Shipwrecked-Alchemists/m20/m20kicad.kicad_pcb

## KiCad design sensorOne/hardware/sensorOnePcb/sensorOnePcb.kicad_pcb

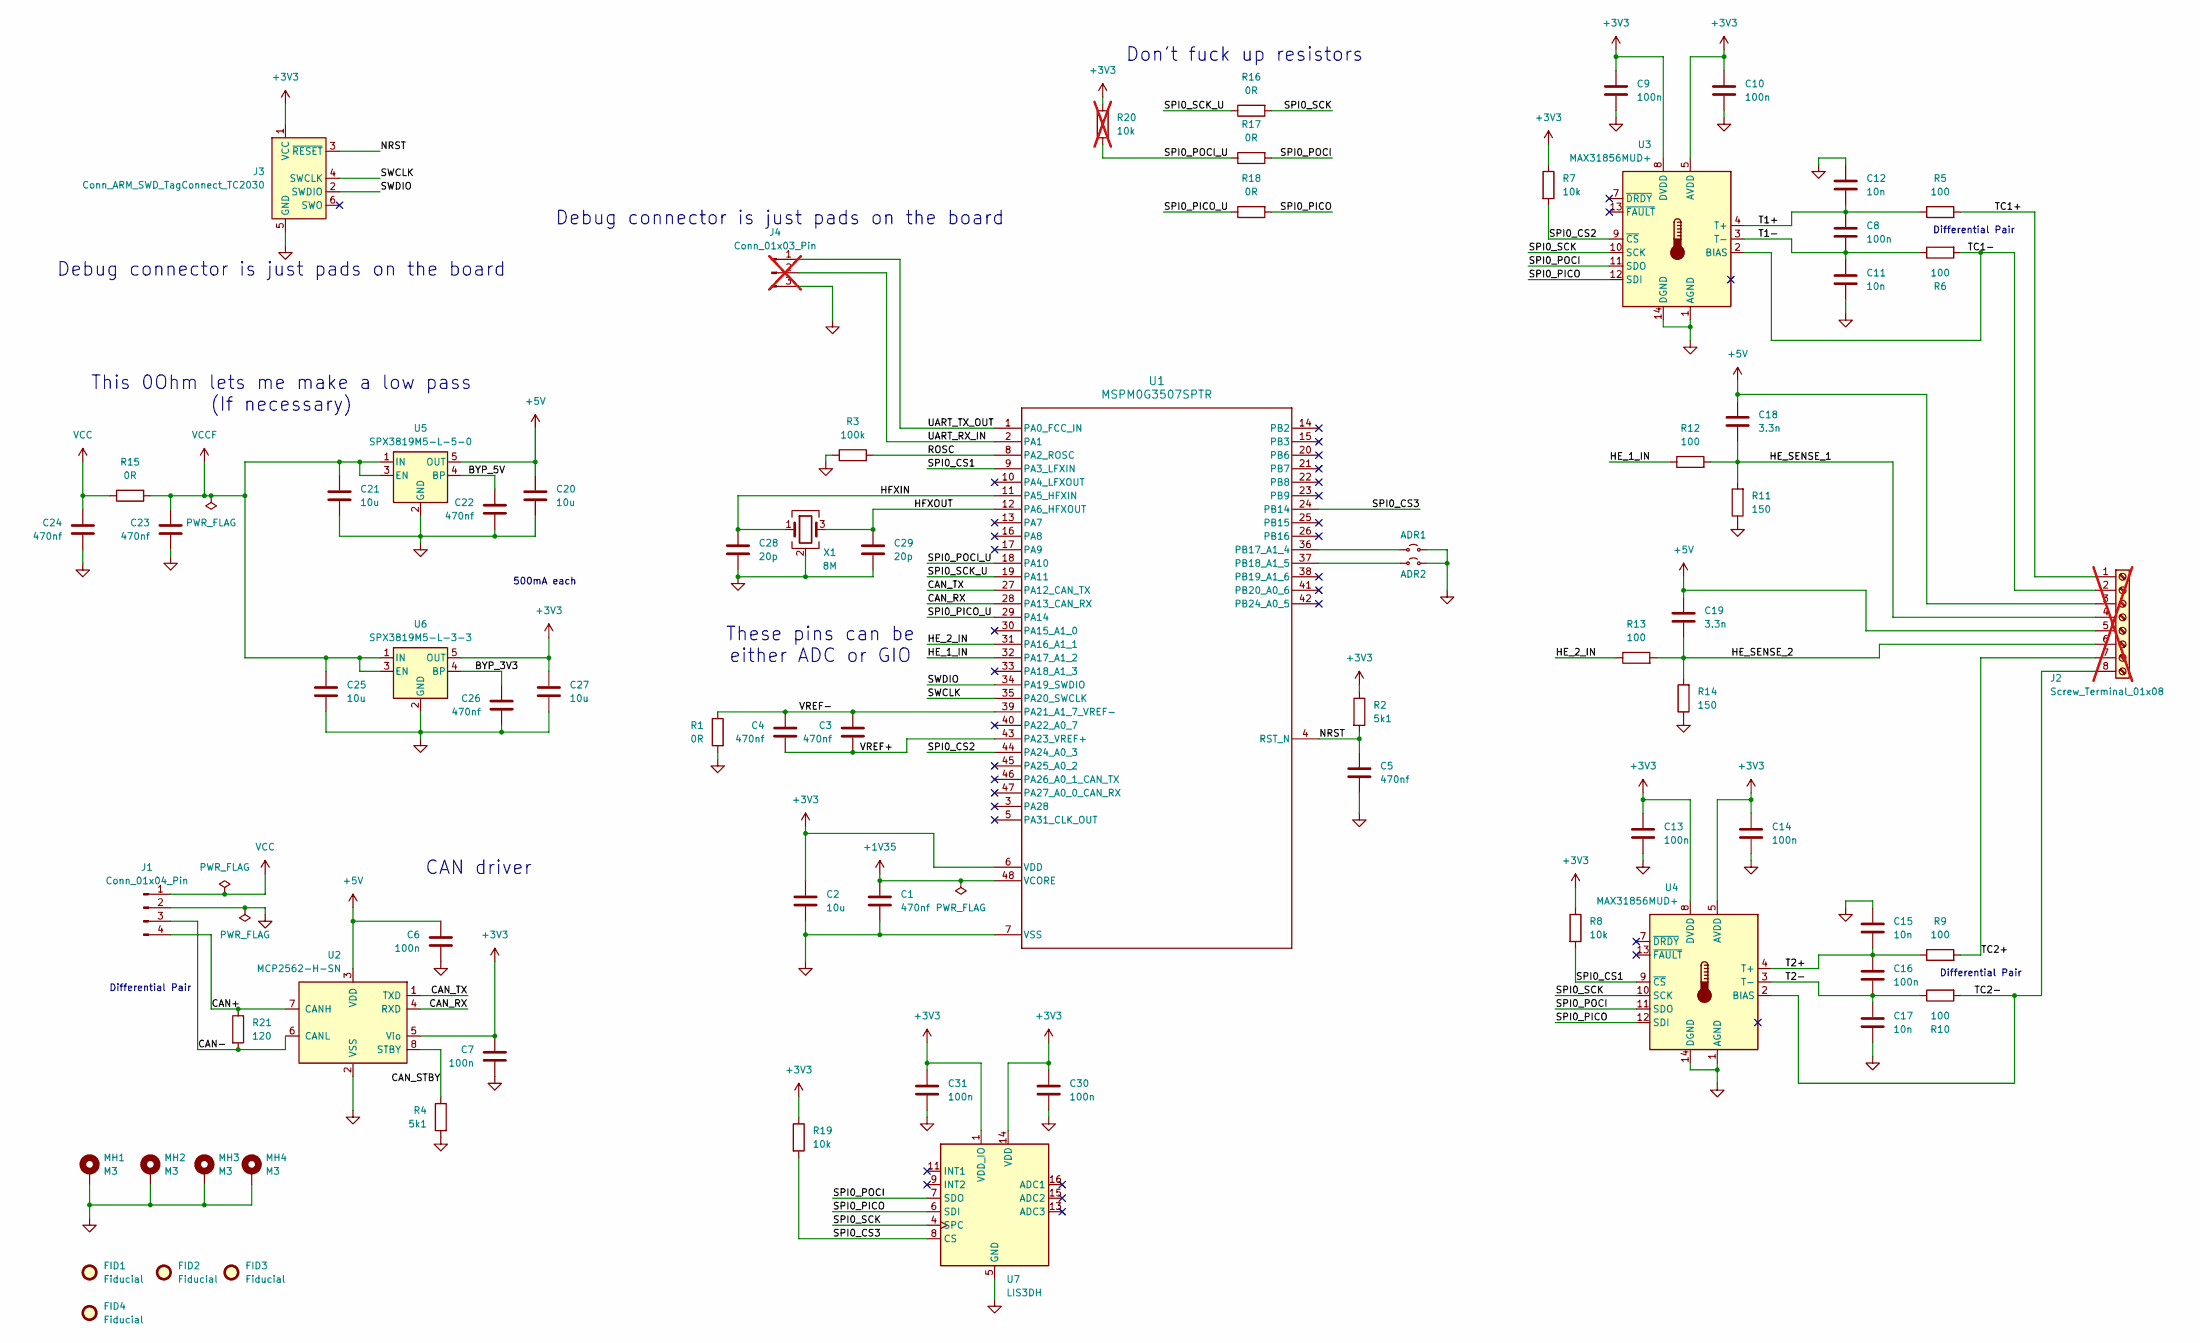
[picture p1: schematic sensorOnePcb.kicad_sch, ${boardName} Schematic]

Parts:
ADR1, ADR2: SolderJumper-2_P1.3mm_Open_RoundedPad1.0x1.5mm
C1, C3, C4, C5, C22, C23, C24, C26: 470nf; C_0603_1608Metric; Manufacturer Part Number CL10B474KA8NNNC; LCSC C1623
C2, C20, C21, C25, C27: 10u; C_0805_2012Metric; Manufacturer Part Number CL21A106KAYNNNE; LCSC C15850
C6, C7, C8, C9, C10, C13, C14, C16, C30, C31: 100n; C_0603_1608Metric; Manufacturer Part Number CC0603KRX7R9BB104; LCSC C14663
C11, C12, C15, C17: 10n; C_0603_1608Metric; Manufacturer Part Number 0603B103K500NT; LCSC C57112
C18, C19: 3.3n; C_0603_1608Metric; Manufacturer Part Number CL10B332KB8NNNC; LCSC C1613
C28, C29: 20p; C_0603_1608Metric; Manufacturer Part Number CL10C200JB8NNNC; LCSC C1648
FID1, FID2, FID3, FID4: Fiducial; Fiducial_1mm_Mask2mm
J1: Conn_01x04_Pin; JST_PH_B4B-PH-K_1x04_P2.00mm_Vertical; Manufacturer Part Number B4B-PH-K-S(LF)(SN); LCSC C131334
J2: Screw_Terminal_01x08; TerminalBlock_Xinya_XY308-2.54-8P_1x08_P2.54mm_Horizontal; not fitted
J3: Conn_ARM_SWD_TagConnect_TC2030; Tag-Connect_TC2030-IDC-FP_2x03_P1.27mm_Vertical
J4: Conn_01x03_Pin; PinHeader_1x03_P2.54mm_Vertical; not fitted
MH1, MH2, MH3, MH4: M3; MountingHole_3.2mm_M3_Pad_Via
R1, R15, R16, R17, R18: 0R; R_0603_1608Metric; Manufacturer Part Number 0603WAF0000T5E; LCSC C21189
R2, R4: 5k1; R_0603_1608Metric; Manufacturer Part Number 0603WAF5101T5E; LCSC C23186
R3: 100k; R_0603_1608Metric; Manufacturer Part Number ERA3AEB104V; LCSC C190609
R5, R6, R9, R10, R12, R13: 100; R_0603_1608Metric; Manufacturer Part Number 0603WAF1000T5E; LCSC C22775
R7, R8, R19: 10k; R_0603_1608Metric; Manufacturer Part Number 0603WAF1002T5E; LCSC C25804
R11, R14: 150; R_0603_1608Metric; Manufacturer Part Number 0603WAF1500T5E; LCSC C22808
R20: 10k; R_0603_1608Metric; Manufacturer Part Number 0603WAF1002T5E; LCSC C25804; not fitted
R21: 120; R_0603_1608Metric; Manufacturer Part Number 0603WAF1200T5E; LCSC C22787
U1: MSPM0G3507SPTR; PT0048A-IPC_A; Manufacturer Part Number MSPM0G3507SPTR; LCSC C22362630
U2: MCP2562-H-SN; SOIC-8_3.9x4.9mm_P1.27mm; Manufacturer Part Number MCP2562-H/SN; LCSC C635955
U3, U4: MAX31856MUD+; TSSOP-14_4.4x5mm_P0.65mm; Manufacturer Part Number MAX31856MUD+; LCSC C116632
U5: SPX3819M5-L-5-0; SOT-23-5; Manufacturer Part Number SPX3819M5-L-5-0/TR; LCSC C13417
U6: SPX3819M5-L-3-3; SOT-23-5; Manufacturer Part Number SPX3819M5-L-3-3/TR; LCSC C9055
U7: LIS3DH; LGA-16_3x3mm_P0.5mm_LayoutBorder3x5y; Manufacturer Part Number LIS3DHTR; LCSC C15134
X1: 8M; Crystal_SMD_3225-4Pin_3.2x2.5mm; Manufacturer Part Number SX3M8.000M20F30TNN; LCSC C2901556

Connections:
+1V35: C1.1, U1.48 (VCORE)
+3V3: C2.1, C7.1, C9.1, C10.1, C13.1, C14.1, C27.1, C30.1, C31.1, J3.1 (VCC), R2.1, R7.1, R8.1, R19.1, R20.1, U1.6 (VDD), U2.5 (Vio), U3.5 (AVDD), U3.8 (DVDD), U4.5 (AVDD), U4.8 (DVDD), U6.5 (OUT), U7.1 (VDD_IO), U7.14 (VDD)
+5V: C6.1, C18.1, C19.1, C20.1, J2.3, J2.5, U2.3 (VDD), U5.5 (OUT)
/BYP_3V3: C26.1, U6.4 (BP)
/BYP_5V: C22.1, U5.4 (BP)
/CAN+: J1.4, R21.1, U2.7 (CANH)
/CAN-: J1.3, R21.2, U2.6 (CANL)
/CAN_RX: U1.28 (PA13_CAN_RX), U2.4 (RXD)
/CAN_STBY: R4.1, U2.8 (STBY)
/CAN_TX: U1.27 (PA12_CAN_TX), U2.1 (TXD)
/HE_1_IN: R12.1, U1.32 (PA17_A1_2)
/HE_2_IN: R13.1, U1.31 (PA16_A1_1)
/HE_SENSE_1: C18.2, J2.4, R11.2, R12.2
/HE_SENSE_2: C19.2, J2.6, R13.2, R14.2
/HFXIN: C28.1, U1.11 (PA5_HFXIN), X1.1
/HFXOUT: C29.1, U1.12 (PA6_HFXOUT), X1.3
/NRST: C5.1, J3.3 (~RESET), R2.2, U1.4 (RST_N)
/ROSC: R3.2, U1.8 (PA2_ROSC)
/SPI0_CS1: R8.2, U1.9 (PA3_LFXIN), U4.9 (~CS)
/SPI0_CS2: R7.2, U1.44 (PA24_A0_3), U3.9 (~CS)
/SPI0_CS3: R19.2, U1.24 (PB14), U7.8 (CS)
/SPI0_PICO: R18.2, U3.12 (SDI), U4.12 (SDI), U7.6 (SDI)
/SPI0_PICO_U: R18.1, U1.29 (PA14)
/SPI0_POCI: R17.2, U3.11 (SDO), U4.11 (SDO), U7.7 (SDO)
/SPI0_POCI_U: R17.1, R20.2, U1.18 (PA10)
/SPI0_SCK: R16.2, U3.10 (SCK), U4.10 (SCK), U7.4 (SPC)
/SPI0_SCK_U: R16.1, U1.19 (PA11)
/SWCLK: J3.4 (SWCLK), U1.35 (PA20_SWCLK)
/SWDIO: J3.2 (SWDIO), U1.34 (PA19_SWDIO)
/T1+: C8.1, C12.2, R5.1, U3.4 (T+)
/T1-: C8.2, C11.1, R6.1, U3.3 (T-)
/T2+: C15.2, C16.1, R9.1, U4.4 (T+)
/T2-: C16.2, C17.1, R10.1, U4.3 (T-)
/TC1+: J2.1, R5.2
/TC1-: J2.2, R6.2, U3.2 (BIAS)
/TC2+: J2.7, R9.2
/TC2-: J2.8, R10.2, U4.2 (BIAS)
/UART_RX_IN: J4.2, U1.2 (PA1)
/UART_TX_OUT: J4.1, U1.1 (PA0_FCC_IN)
/VREF+: C3.2, C4.2, U1.43 (PA23_VREF+)
/VREF-: C3.1, C4.1, R1.1, U1.39 (PA21_A1_7_VREF-)
GND: ADR1.2 (B), ADR2.2 (B), C1.2, C2.2, C5.2, C6.2, C7.2, C9.2, C10.2, C11.2, C12.1, C13.2, C14.2, C15.1, C17.2, C20.2, C21.2, C22.2, C23.2, C24.2, C25.2, C26.2, C27.2, C28.2, C29.2, C30.2, C31.2, J1.2, J3.5 (GND), J4.3, MH1.1 (1_1), MH2.1 (1_1), MH3.1 (1_1), MH4.1 (1_1), R1.2, R3.1, R4.2, R11.1, R14.1, U1.7 (VSS), U2.2 (VSS), U3.1 (AGND), U3.14 (DGND), U4.1 (AGND), U4.14 (DGND), U5.2 (GND), U6.2 (GND), U7.5 (GND), U7.10 (GND), U7.12 (GND), X1.2 (G), X1.4 (G)
unnamed: ADR1.1 (A), U1.36 (PB17_A1_4)
unnamed: ADR2.1 (A), U1.37 (PB18_A1_5)
VCC: C24.1, J1.1, R15.1
VCCF: C21.1, C23.1, C25.1, R15.2, U5.1 (IN), U5.3 (EN), U6.1 (IN), U6.3 (EN)

Notes on the sheet:
Debug connector is just pads on the board
Differential Pair
500mA each
Don't fuck up resistors
These pins can be either ADC or GIO
CAN driver
This 0Ohm lets me make a low pass (If necessary)

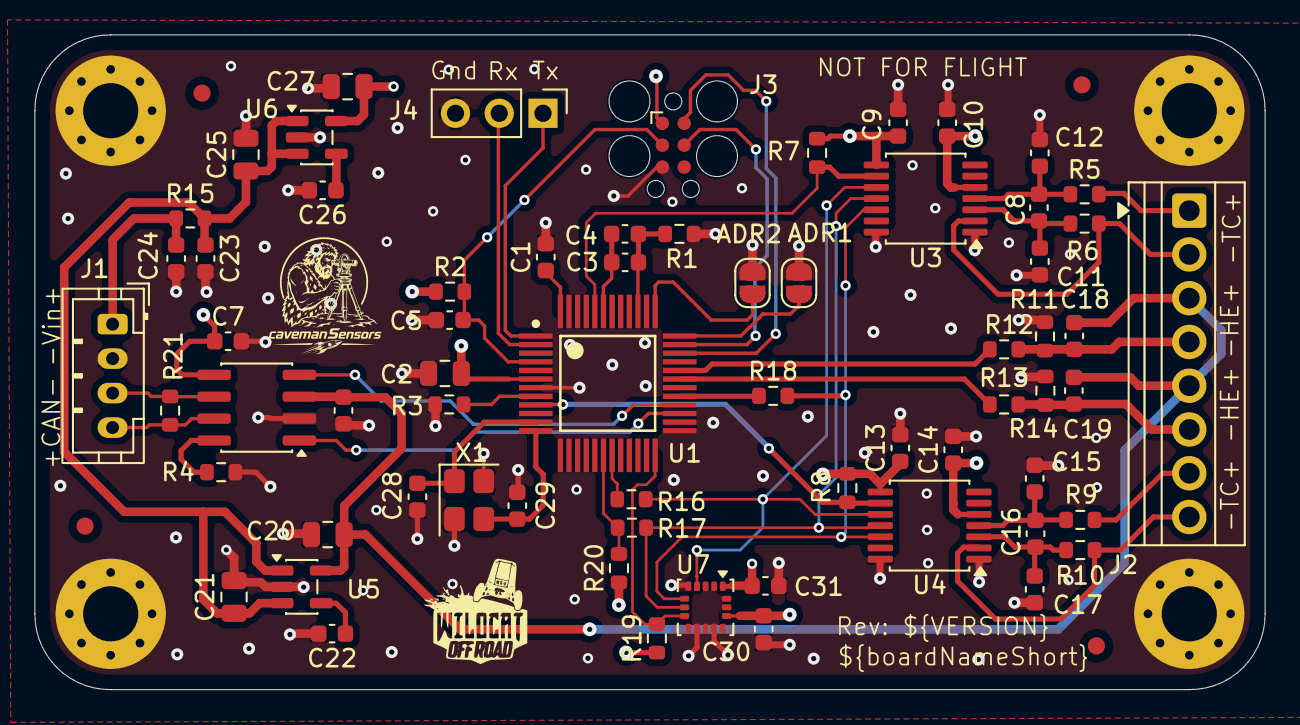
[picture p2: board sensorOnePcb.kicad_pcb from above]

Board: 4 copper layers, 71.4 x 38.0 mm, 74 parts (0 on the bottom side), 46 nets.
