Shipwrecked-Alchemists/m20/(commit log)

2026-07-31 adding LPS22 connection
    [m20kicad.kicad_sch]
2026-09-12 adding expansion connector
    [m20kicad.kicad_sch]
